oldcompcz/Mato-replica/KiCad/Mato/pcb-src/mato-back.png

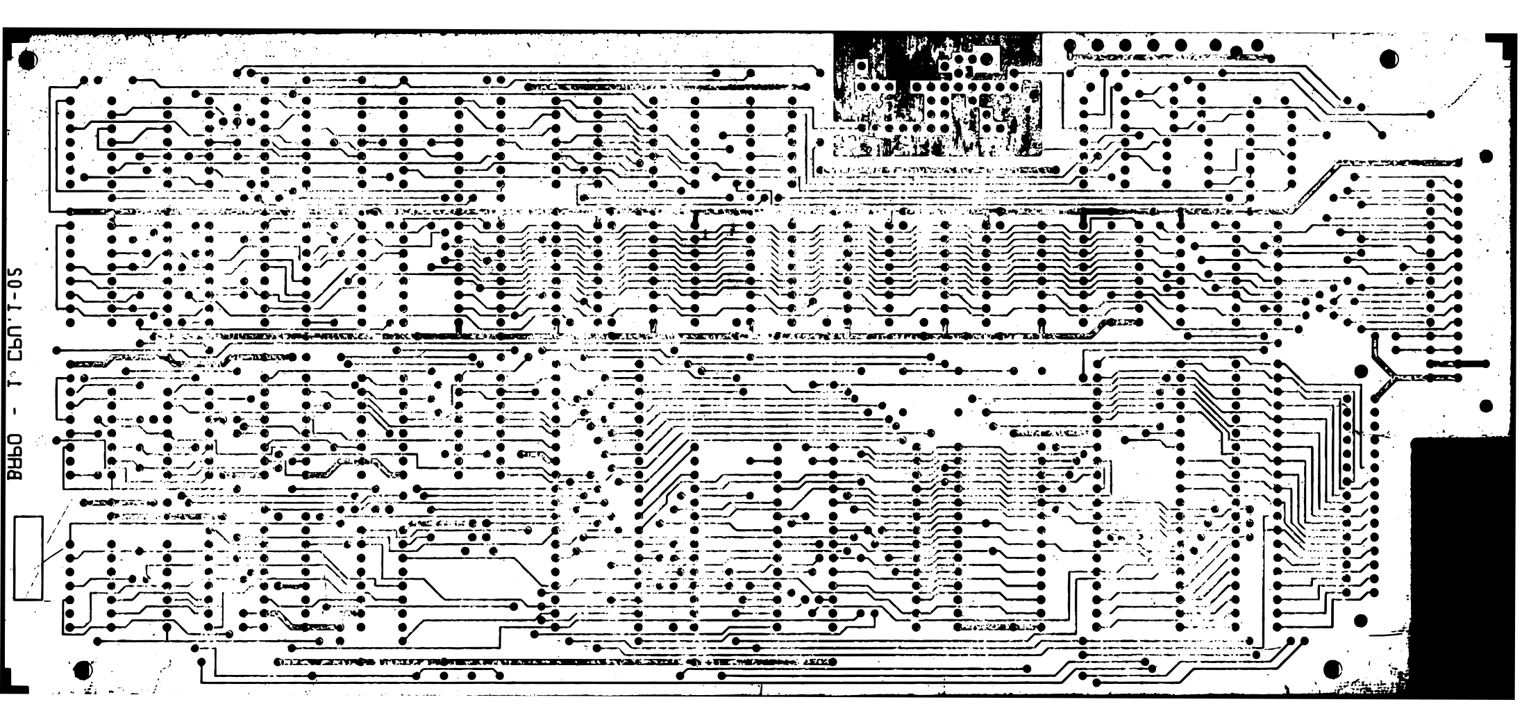
KiCad/Mato/pcb-src/mato-back.png
