oldcompcz/Mato-replica/KiCad/Mato/pcb-src/mato-front.png

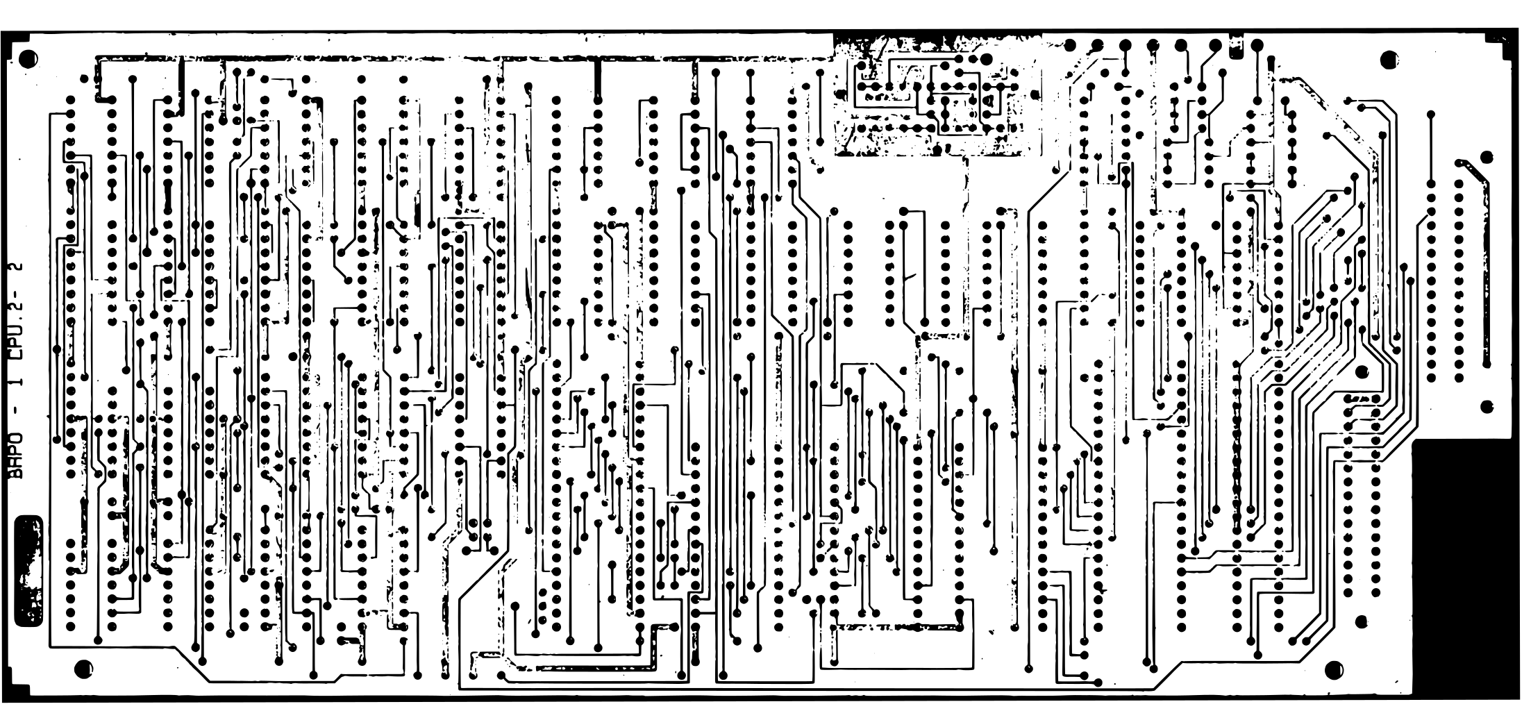
KiCad/Mato/pcb-src/mato-front.png
