oldcompcz/Mato-replica/Schemes/Stavebnica_mikropocitaca_MATO_scan_Zarucny_list_300.jpg

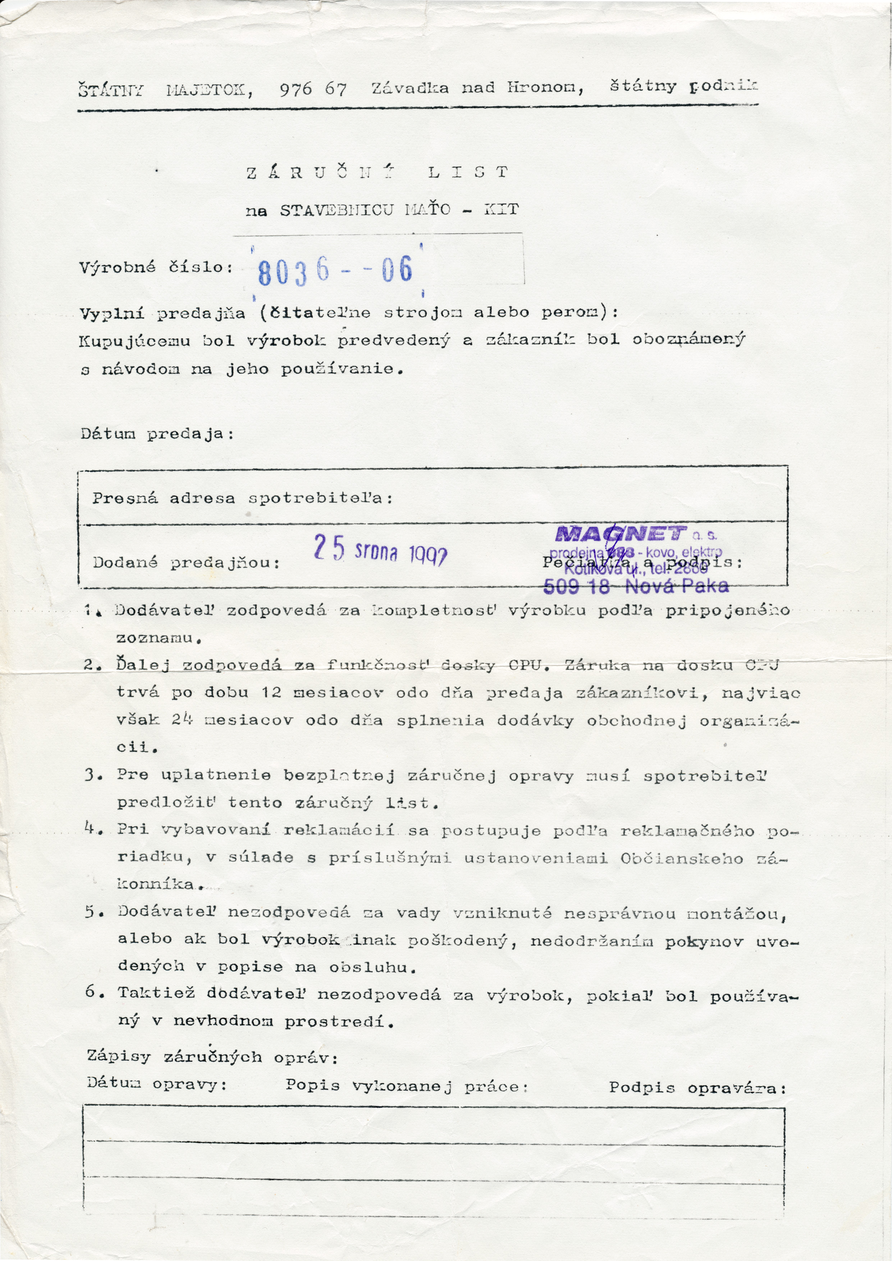
Schemes/Stavebnica_mikropocitaca_MATO_scan_Zarucny_list_300.jpg
