oldcompcz/Mato-replica/KiCad/Mato.kicad_pcb

## KiCad design KiCad/Mato.kicad_pcb (2021-07-30)

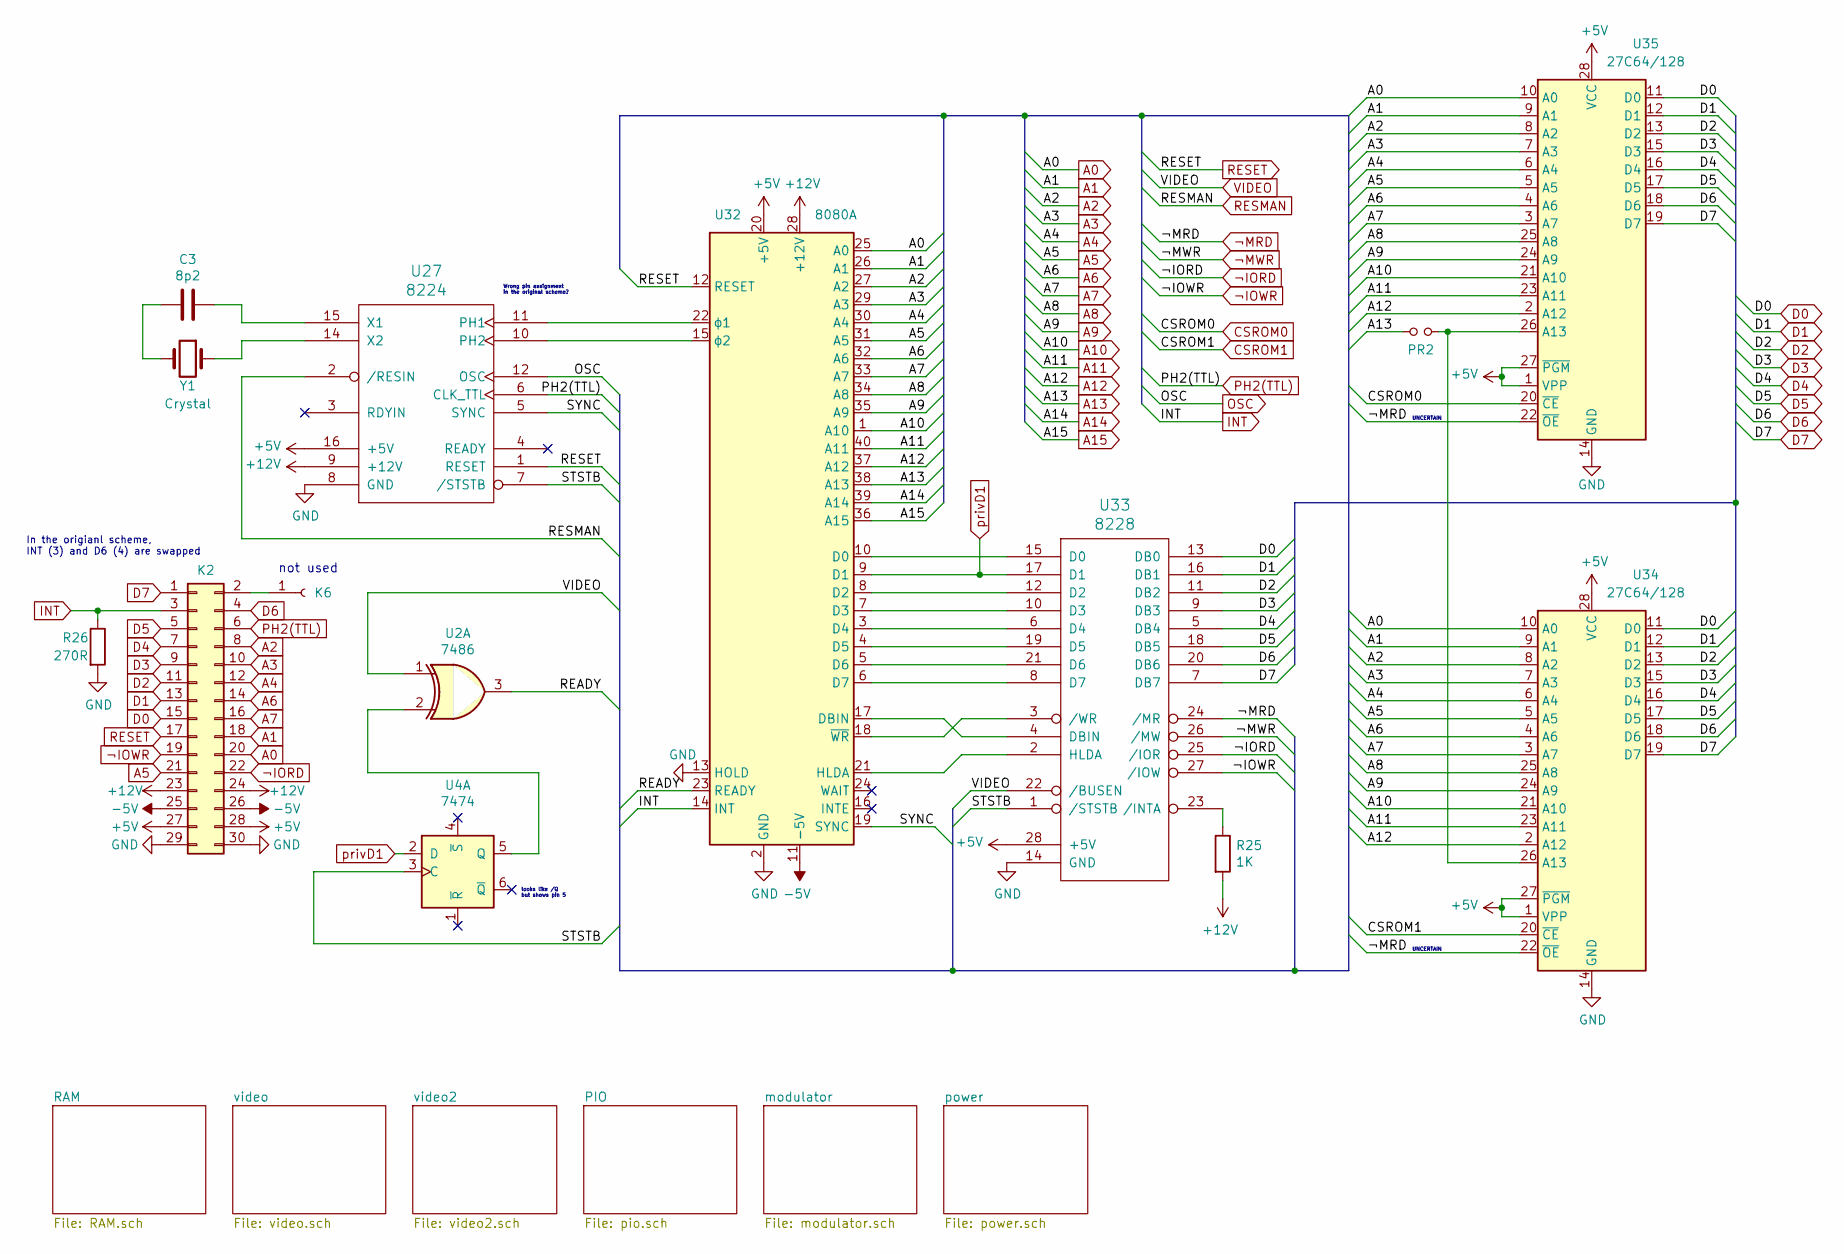
[picture p6: schematic Mato.sch]

Parts:
C3: 8p2; C_Disc_D3.4mm_W2.1mm_P2.50mm
K2: Conn_02x15_Odd_Even; TX5133011-mato
K6: K6; mato-K6
PR2: Jumper_NO_Small; PinHeader_1x02_P2.54mm_Vertical
R25: 1K; R_Axial_DIN0204_L3.6mm_D1.6mm_P7.62mm_Horizontal
R26: 270R; R_Axial_Bend
U2: 7486; DIP-14_W7.62mm
U4: 7474; DIP-14_W7.62mm
U27: 8224; DIP-16_W7.62mm
U32: 8080A; DIP-40_W15.24mm
U33: 8228; DIP-28_W15.24mm
U34, U35: 27C64/128; DIP-28_W15.24mm
Y1: Crystal; Crystal_HC18-U_Horizontal

Connections:
+5V: K2.27, K2.28, U27.16 (+5V), U32.20 (+5V), U33.28 (+5V), U34.1 (VPP), U34.27 (~PGM), U34.28 (VCC), U35.1 (VPP), U35.27 (~PGM), U35.28 (VCC); also elsewhere on the board
+12V: K2.23, K2.24, R25.2, U27.9 (+12V), U32.28 (+12V); also elsewhere on the board
-5V: K2.25, K2.26, U32.11 (-5V); also elsewhere on the board
/READY: U2.3, U32.23 (READY)
/STSTB: U4.3 (C), U27.7 (/STSTB), U33.1 (/STSTB)
/SYNC: U27.5 (SYNC), U32.19 (SYNC)
A0: K2.20, U32.25 (A0), U34.10 (A0), U35.10 (A0); also elsewhere on the board
A1: K2.18, U32.26 (A1), U34.9 (A1), U35.9 (A1); also elsewhere on the board
A2: K2.8, U32.27 (A2), U34.8 (A2), U35.8 (A2); also elsewhere on the board
A3: K2.10, U32.29 (A3), U34.7 (A3), U35.7 (A3); also elsewhere on the board
A4: K2.12, U32.30 (A4), U34.6 (A4), U35.6 (A4); also elsewhere on the board
A5: K2.21, U32.31 (A5), U34.5 (A5), U35.5 (A5); also elsewhere on the board
A6: K2.14, U32.32 (A6), U34.4 (A6), U35.4 (A6); also elsewhere on the board
A7: K2.16, U32.33 (A7), U34.3 (A7), U35.3 (A7); also elsewhere on the board
A8: U32.34 (A8), U34.25 (A8), U35.25 (A8); also elsewhere on the board
A9: U32.35 (A9), U34.24 (A9), U35.24 (A9); also elsewhere on the board
A10: U32.1 (A10), U34.21 (A10), U35.21 (A10); also elsewhere on the board
A11: U32.40 (A11), U34.23 (A11), U35.23 (A11); also elsewhere on the board
A12: U32.37 (A12), U34.2 (A12), U35.2 (A12); also elsewhere on the board
A13: PR2.1, U32.38 (A13); also elsewhere on the board
A14: U32.39 (A14); also elsewhere on the board
A15: U32.36 (A15); also elsewhere on the board
CSROM0: U35.20 (~CE); also elsewhere on the board
CSROM1: U34.20 (~CE); also elsewhere on the board
D0: K2.15, U33.13 (DB0), U34.11 (D0), U35.11 (D0); also elsewhere on the board
D1: K2.13, U33.16 (DB1), U34.12 (D1), U35.12 (D1); also elsewhere on the board
D2: K2.11, U33.11 (DB2), U34.13 (D2), U35.13 (D2); also elsewhere on the board
D3: K2.9, U33.9 (DB3), U34.15 (D3), U35.15 (D3); also elsewhere on the board
D4: K2.7, U33.5 (DB4), U34.16 (D4), U35.16 (D4); also elsewhere on the board
D5: K2.5, U33.18 (DB5), U34.17 (D5), U35.17 (D5); also elsewhere on the board
D6: K2.4, U33.20 (DB6), U34.18 (D6), U35.18 (D6); also elsewhere on the board
D7: K2.1, U33.7 (DB7), U34.19 (D7), U35.19 (D7); also elsewhere on the board
GND: K2.29, K2.30, R26.2, U27.8 (GND), U32.2 (GND), U32.13 (HOLD), U33.14 (GND), U34.14 (GND), U35.14 (GND); also elsewhere on the board
INT: K2.3, R26.1, U32.14 (INT)
unnamed: C3.1, Y1.2
unnamed: C3.2, U27.15 (X1)
unnamed: K2.2, K6.1
unnamed: PR2.2, U34.26 (A13), U35.26 (A13)
unnamed: R25.1, U33.23 (/INTA)
unnamed: U2.2, U4.5 (Q)
unnamed: U27.10 (PH2), U32.15 (ϕ2)
unnamed: U27.11 (PH1), U32.22 (ϕ1)
unnamed: U27.14 (X2), Y1.1
unnamed: U32.3 (D4), U33.6 (D4)
unnamed: U32.4 (D5), U33.19 (D5)
unnamed: U32.5 (D6), U33.21 (D6)
unnamed: U32.6 (D7), U33.8 (D7)
unnamed: U32.7 (D3), U33.10 (D3)
unnamed: U32.8 (D2), U33.12 (D2)
unnamed: U32.10 (D0), U33.15 (D0)
unnamed: U32.17 (DBIN), U33.4 (DBIN)
unnamed: U32.18 (~WR~), U33.3 (/WR)
unnamed: U32.21 (HLDA), U33.2 (HLDA)
OSC: U27.12 (OSC); also elsewhere on the board
PH2(TTL): K2.6, U27.6 (CLK_TTL); also elsewhere on the board
RESET: K2.17, U27.1 (RESET), U32.12 (RESET); also elsewhere on the board
RESMAN: U27.2 (/RESIN); also elsewhere on the board
VIDEO: U2.1, U33.22 (/BUSEN); also elsewhere on the board
privD1: U4.2 (D), U32.9 (D1), U33.17 (D1)
¬IORD: K2.22, U33.25 (/IOR); also elsewhere on the board
¬IOWR: K2.19, U33.27 (/IOW); also elsewhere on the board
¬MRD: U33.24 (/MR), U34.22 (~OE), U35.22 (~OE); also elsewhere on the board
¬MWR: U33.26 (/MW); also elsewhere on the board

Notes on the sheet:
looks like /Q but shows pin 5
Wrong pin assignment in the original scheme?
UNCERTAIN
In the origianl scheme, INT (3) and D6 (4) are swapped
not used

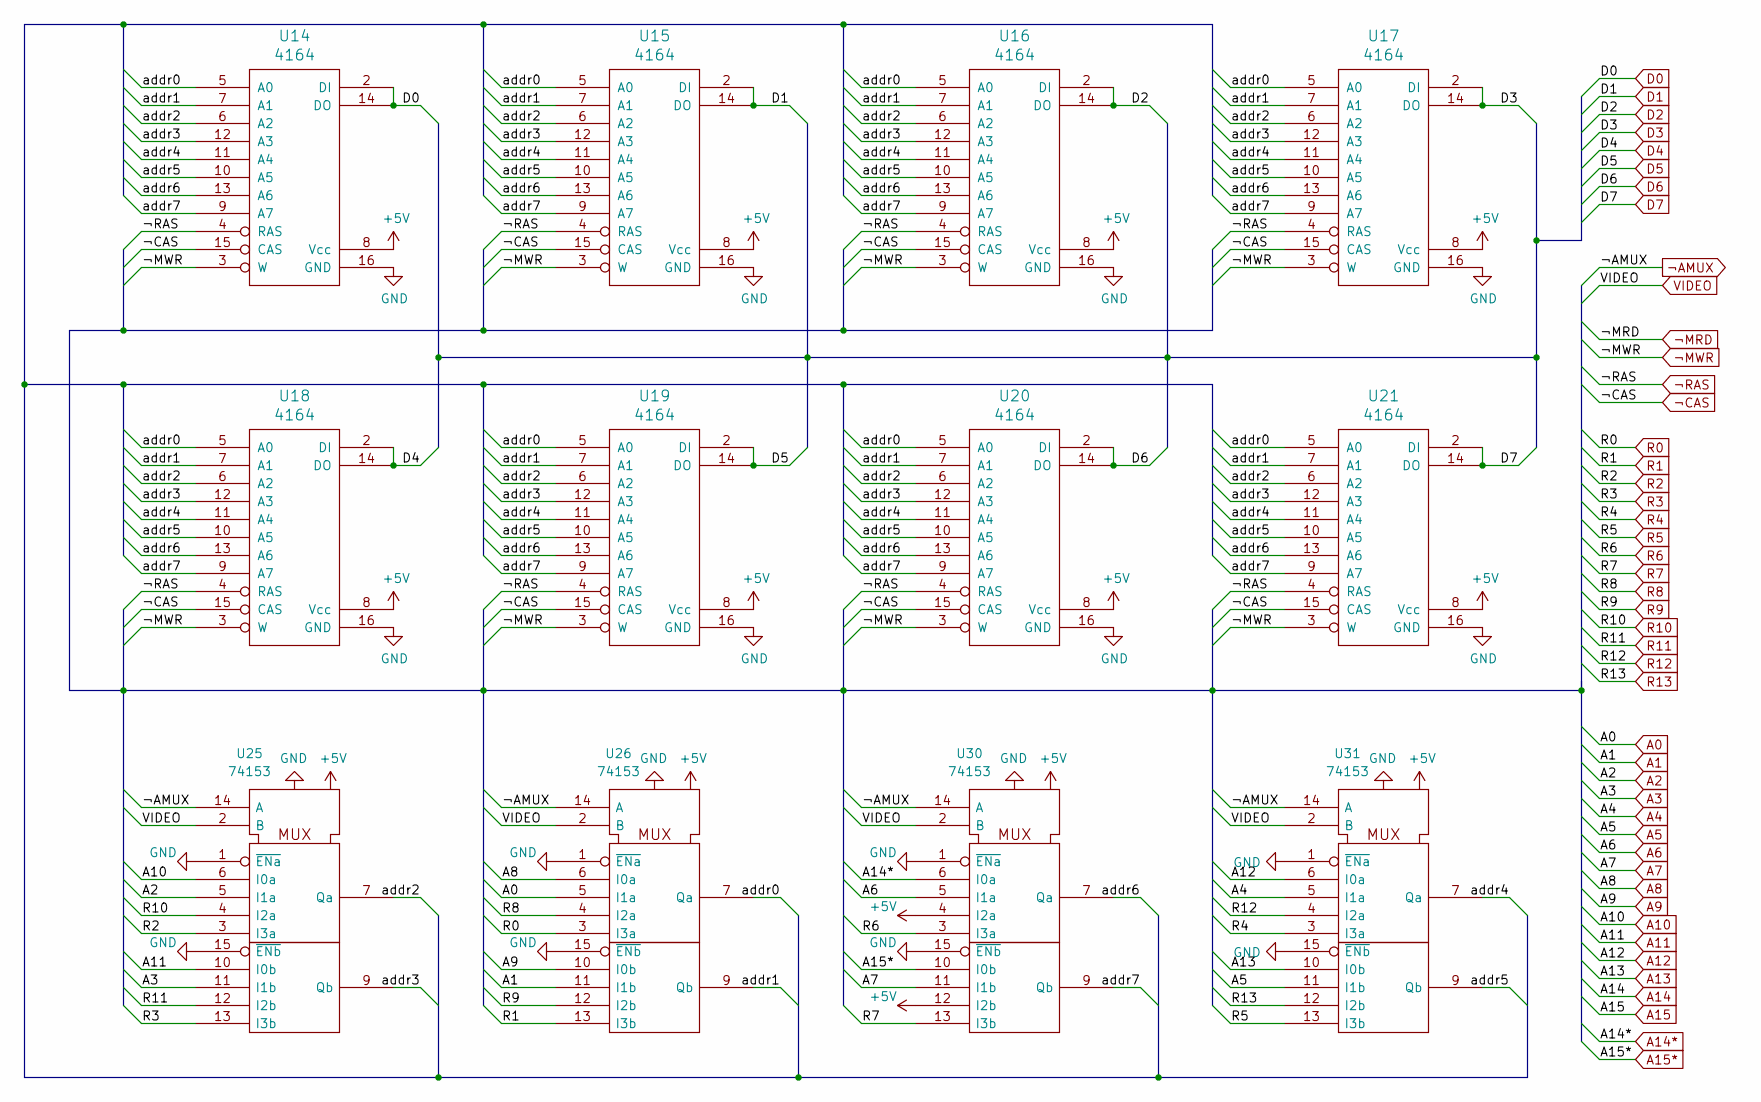
[picture p7: schematic RAM.sch]

Parts:
U14, U15, U16, U17, U18, U19, U20, U21: 4164; DIP-16_W7.62mm
U25, U26, U30, U31: 74153; DIP-16_W7.62mm

Connections:
+5V: U14.8 (Vcc), U15.8 (Vcc), U16.8 (Vcc), U17.8 (Vcc), U18.8 (Vcc), U19.8 (Vcc), U20.8 (Vcc), U21.8 (Vcc), U25.16 (VCC), U26.16 (VCC), U30.4 (I2a), U30.12 (I2b), U30.16 (VCC), U31.16 (VCC); also elsewhere on the board
/RAM/addr0: U14.5 (A0), U15.5 (A0), U16.5 (A0), U17.5 (A0), U18.5 (A0), U19.5 (A0), U20.5 (A0), U21.5 (A0), U26.7 (Qa)
/RAM/addr1: U14.7 (A1), U15.7 (A1), U16.7 (A1), U17.7 (A1), U18.7 (A1), U19.7 (A1), U20.7 (A1), U21.7 (A1), U26.9 (Qb)
/RAM/addr2: U14.6 (A2), U15.6 (A2), U16.6 (A2), U17.6 (A2), U18.6 (A2), U19.6 (A2), U20.6 (A2), U21.6 (A2), U25.7 (Qa)
/RAM/addr3: U14.12 (A3), U15.12 (A3), U16.12 (A3), U17.12 (A3), U18.12 (A3), U19.12 (A3), U20.12 (A3), U21.12 (A3), U25.9 (Qb)
/RAM/addr4: U14.11 (A4), U15.11 (A4), U16.11 (A4), U17.11 (A4), U18.11 (A4), U19.11 (A4), U20.11 (A4), U21.11 (A4), U31.7 (Qa)
/RAM/addr5: U14.10 (A5), U15.10 (A5), U16.10 (A5), U17.10 (A5), U18.10 (A5), U19.10 (A5), U20.10 (A5), U21.10 (A5), U31.9 (Qb)
/RAM/addr6: U14.13 (A6), U15.13 (A6), U16.13 (A6), U17.13 (A6), U18.13 (A6), U19.13 (A6), U20.13 (A6), U21.13 (A6), U30.7 (Qa)
/RAM/addr7: U14.9 (A7), U15.9 (A7), U16.9 (A7), U17.9 (A7), U18.9 (A7), U19.9 (A7), U20.9 (A7), U21.9 (A7), U30.9 (Qb)
A0: U26.5 (I1a); also elsewhere on the board
A1: U26.11 (I1b); also elsewhere on the board
A2: U25.5 (I1a); also elsewhere on the board
A3: U25.11 (I1b); also elsewhere on the board
A4: U31.5 (I1a); also elsewhere on the board
A5: U31.11 (I1b); also elsewhere on the board
A6: U30.5 (I1a); also elsewhere on the board
A7: U30.11 (I1b); also elsewhere on the board
A8: U26.6 (I0a); also elsewhere on the board
A9: U26.10 (I0b); also elsewhere on the board
A10: U25.6 (I0a); also elsewhere on the board
A11: U25.10 (I0b); also elsewhere on the board
A12: U31.6 (I0a); also elsewhere on the board
A13: U31.10 (I0b); also elsewhere on the board
A14*: U30.6 (I0a); also elsewhere on the board
A15*: U30.10 (I0b); also elsewhere on the board
D0: U14.2 (DI), U14.14 (DO); also elsewhere on the board
D1: U15.2 (DI), U15.14 (DO); also elsewhere on the board
D2: U16.2 (DI), U16.14 (DO); also elsewhere on the board
D3: U17.2 (DI), U17.14 (DO); also elsewhere on the board
D4: U18.2 (DI), U18.14 (DO); also elsewhere on the board
D5: U19.2 (DI), U19.14 (DO); also elsewhere on the board
D6: U20.2 (DI), U20.14 (DO); also elsewhere on the board
D7: U21.2 (DI), U21.14 (DO); also elsewhere on the board
GND: U14.16 (GND), U15.16 (GND), U16.16 (GND), U17.16 (GND), U18.16 (GND), U19.16 (GND), U20.16 (GND), U21.16 (GND), U25.1 (~ENa), U25.8 (GND), U25.15 (~ENb), U26.1 (~ENa), U26.8 (GND), U26.15 (~ENb), U30.1 (~ENa), U30.8 (GND), U30.15 (~ENb), U31.1 (~ENa), U31.8 (GND), U31.15 (~ENb); also elsewhere on the board
R0: U26.3 (I3a); also elsewhere on the board
R1: U26.13 (I3b); also elsewhere on the board
R2: U25.3 (I3a); also elsewhere on the board
R3: U25.13 (I3b); also elsewhere on the board
R4: U31.3 (I3a); also elsewhere on the board
R5: U31.13 (I3b); also elsewhere on the board
R6: U30.3 (I3a); also elsewhere on the board
R7: U30.13 (I3b); also elsewhere on the board
R8: U26.4 (I2a); also elsewhere on the board
R9: U26.12 (I2b); also elsewhere on the board
R10: U25.4 (I2a); also elsewhere on the board
R11: U25.12 (I2b); also elsewhere on the board
R12: U31.4 (I2a); also elsewhere on the board
R13: U31.12 (I2b); also elsewhere on the board
VIDEO: U25.2 (B), U26.2 (B), U30.2 (B), U31.2 (B); also elsewhere on the board
¬AMUX: U25.14 (A), U26.14 (A), U30.14 (A), U31.14 (A); also elsewhere on the board
¬CAS: U14.15 (CAS), U15.15 (CAS), U16.15 (CAS), U17.15 (CAS), U18.15 (CAS), U19.15 (CAS), U20.15 (CAS), U21.15 (CAS); also elsewhere on the board
¬MWR: U14.3 (W), U15.3 (W), U16.3 (W), U17.3 (W), U18.3 (W), U19.3 (W), U20.3 (W), U21.3 (W); also elsewhere on the board
¬RAS: U14.4 (RAS), U15.4 (RAS), U16.4 (RAS), U17.4 (RAS), U18.4 (RAS), U19.4 (RAS), U20.4 (RAS), U21.4 (RAS); also elsewhere on the board

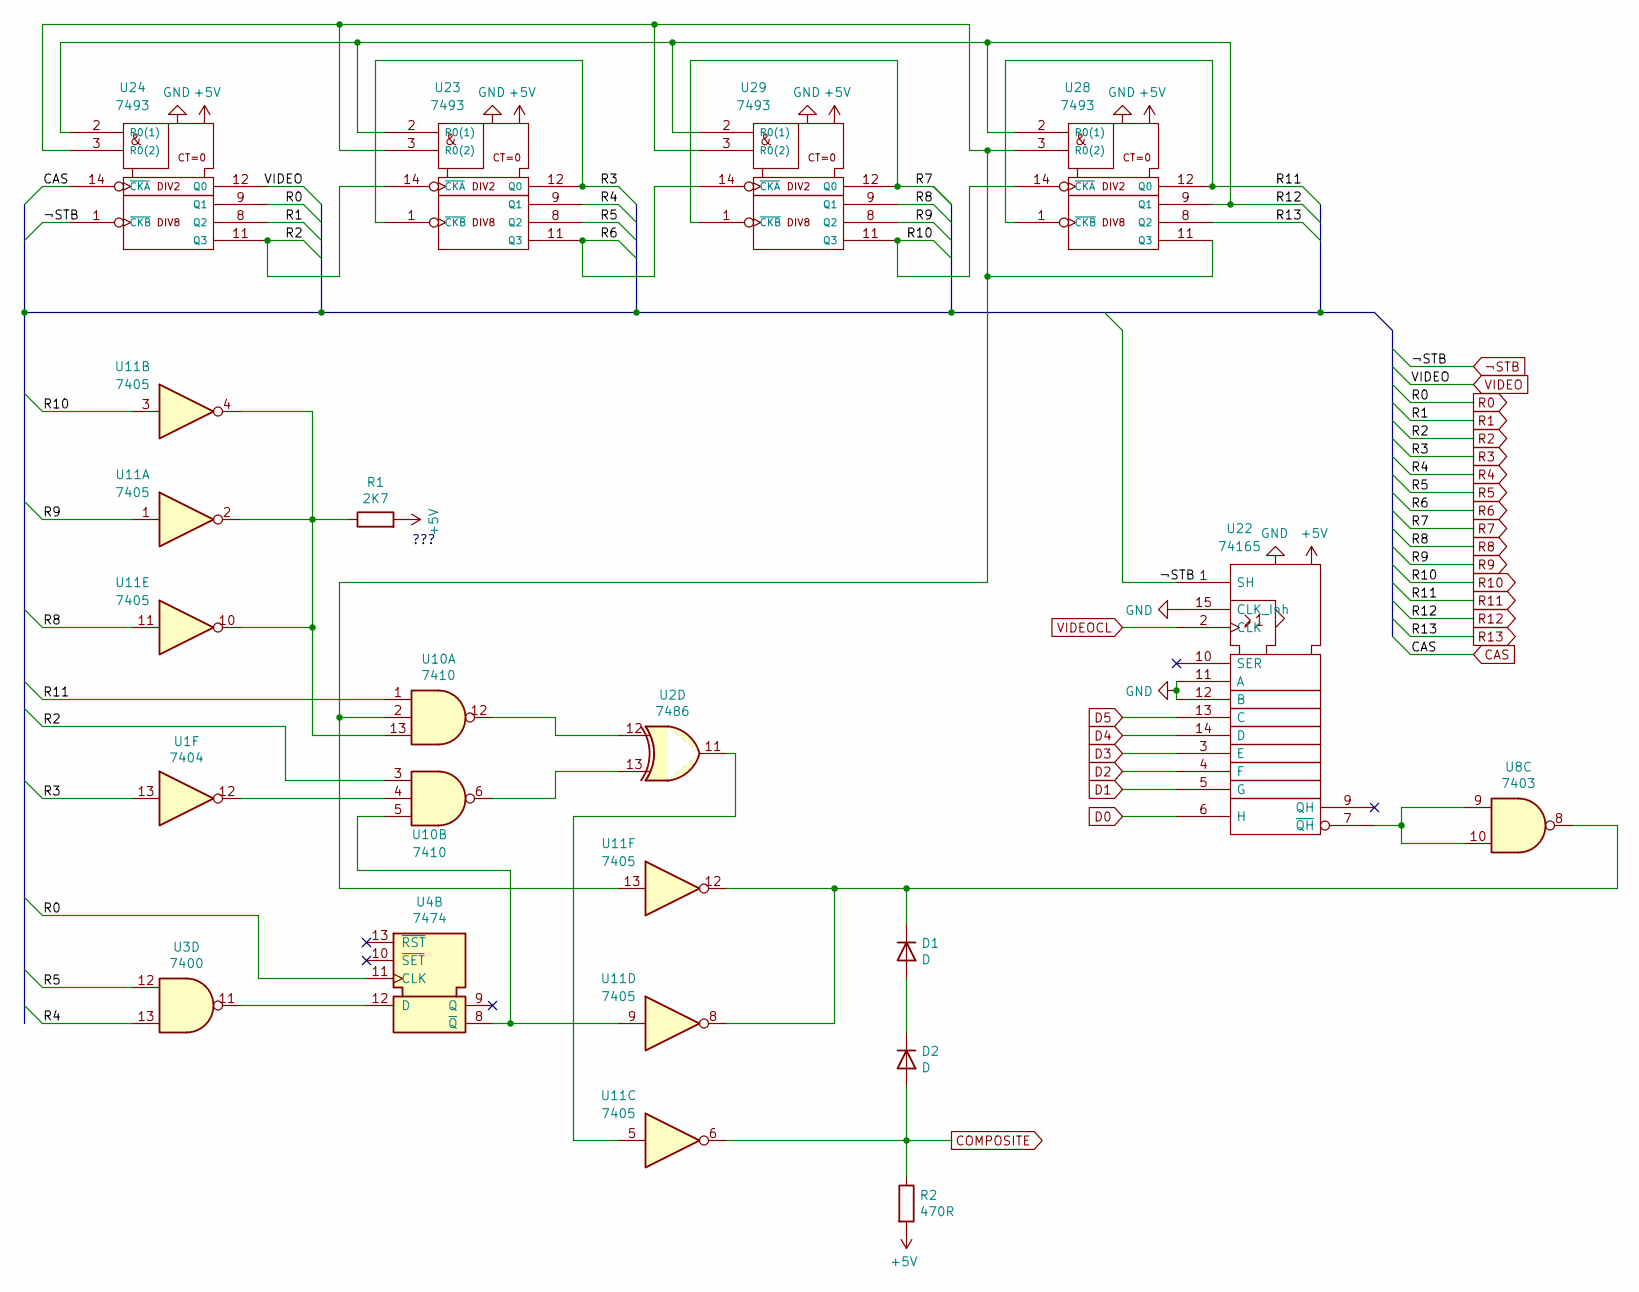
[picture p8: schematic video.sch]

Parts:
D1, D2: D; D_DO-34_SOD68_P7.62mm_Horizontal
R1: 2K7; R_Axial_DIN0204_L3.6mm_D1.6mm_P7.62mm_Horizontal
R2: 470R; R_Axial_DIN0204_L3.6mm_D1.6mm_P7.62mm_Horizontal
U1: 7404; DIP-14_W7.62mm
U2: 7486; DIP-14_W7.62mm
U3: 7400; DIP-14_W7.62mm
U4: 7474; DIP-14_W7.62mm
U8: 7403; DIP-14_W7.62mm
U10: 7410; DIP-14_W7.62mm
U11: 7405; DIP-14_W7.62mm
U22: 74165; DIP-16_W7.62mm
U23, U24, U28, U29: 7493; DIP-14_W7.62mm

Connections:
+5V: R1.2, R2.2, U22.16 (VCC), U23.5 (VCC), U24.5 (VCC), U28.5 (VCC), U29.5 (VCC); also elsewhere on the board
CAS: U24.14 (~CKA); also elsewhere on the board
COMPOSITE: D2.2 (A), R2.1, U11.6; also elsewhere on the board
D0: U22.6 (H); also elsewhere on the board
D1: U22.5 (G); also elsewhere on the board
D2: U22.4 (F); also elsewhere on the board
D3: U22.3 (E); also elsewhere on the board
D4: U22.14 (D); also elsewhere on the board
D5: U22.13 (C); also elsewhere on the board
GND: U22.8 (GND), U22.11 (A), U22.12 (B), U22.15 (CLK_Inh), U23.10 (GND), U24.10 (GND), U28.10 (GND), U29.10 (GND); also elsewhere on the board
unnamed: D1.1 (K), U8.8, U11.8, U11.12
unnamed: D1.2 (A), D2.1 (K)
unnamed: R1.1, U10.13, U11.2, U11.4, U11.10
unnamed: U1.12, U10.4
unnamed: U3.11, U4.12 (D)
unnamed: U10.2, U11.13, U23.3 (R0(2)), U24.3 (R0(2)), U28.3 (R0(2)), U28.11 (Q3), U29.3 (R0(2))
unnamed: U4.8 (~Q), U10.5, U11.9
unnamed: U2.13, U10.6
unnamed: U2.12, U10.12
unnamed: U2.11, U11.5
unnamed: U8.9, U8.10, U22.7 (~QH)
R0: U4.11 (C), U24.9 (Q1); also elsewhere on the board
R1: U24.8 (Q2); also elsewhere on the board
R2: U10.3, U23.14 (~CKA), U24.11 (Q3); also elsewhere on the board
R3: U1.13, U23.1 (~CKB), U23.12 (Q0); also elsewhere on the board
R4: U3.13, U23.9 (Q1); also elsewhere on the board
R5: U3.12, U23.8 (Q2); also elsewhere on the board
R6: U23.11 (Q3), U29.14 (~CKA); also elsewhere on the board
R7: U29.1 (~CKB), U29.12 (Q0); also elsewhere on the board
R8: U11.11, U29.9 (Q1); also elsewhere on the board
R9: U11.1, U29.8 (Q2); also elsewhere on the board
R10: U11.3, U28.14 (~CKA), U29.11 (Q3); also elsewhere on the board
R11: U10.1, U28.1 (~CKB), U28.12 (Q0); also elsewhere on the board
R12: U23.2 (R0(1)), U24.2 (R0(1)), U28.2 (R0(1)), U28.9 (Q1), U29.2 (R0(1)); also elsewhere on the board
R13: U28.8 (Q2); also elsewhere on the board
VIDEO: U24.12 (Q0); also elsewhere on the board
VIDEOCL: U22.2 (CLK); also elsewhere on the board
¬STB: U22.1 (SH), U24.1 (~CKB); also elsewhere on the board

Notes on the sheet:
???

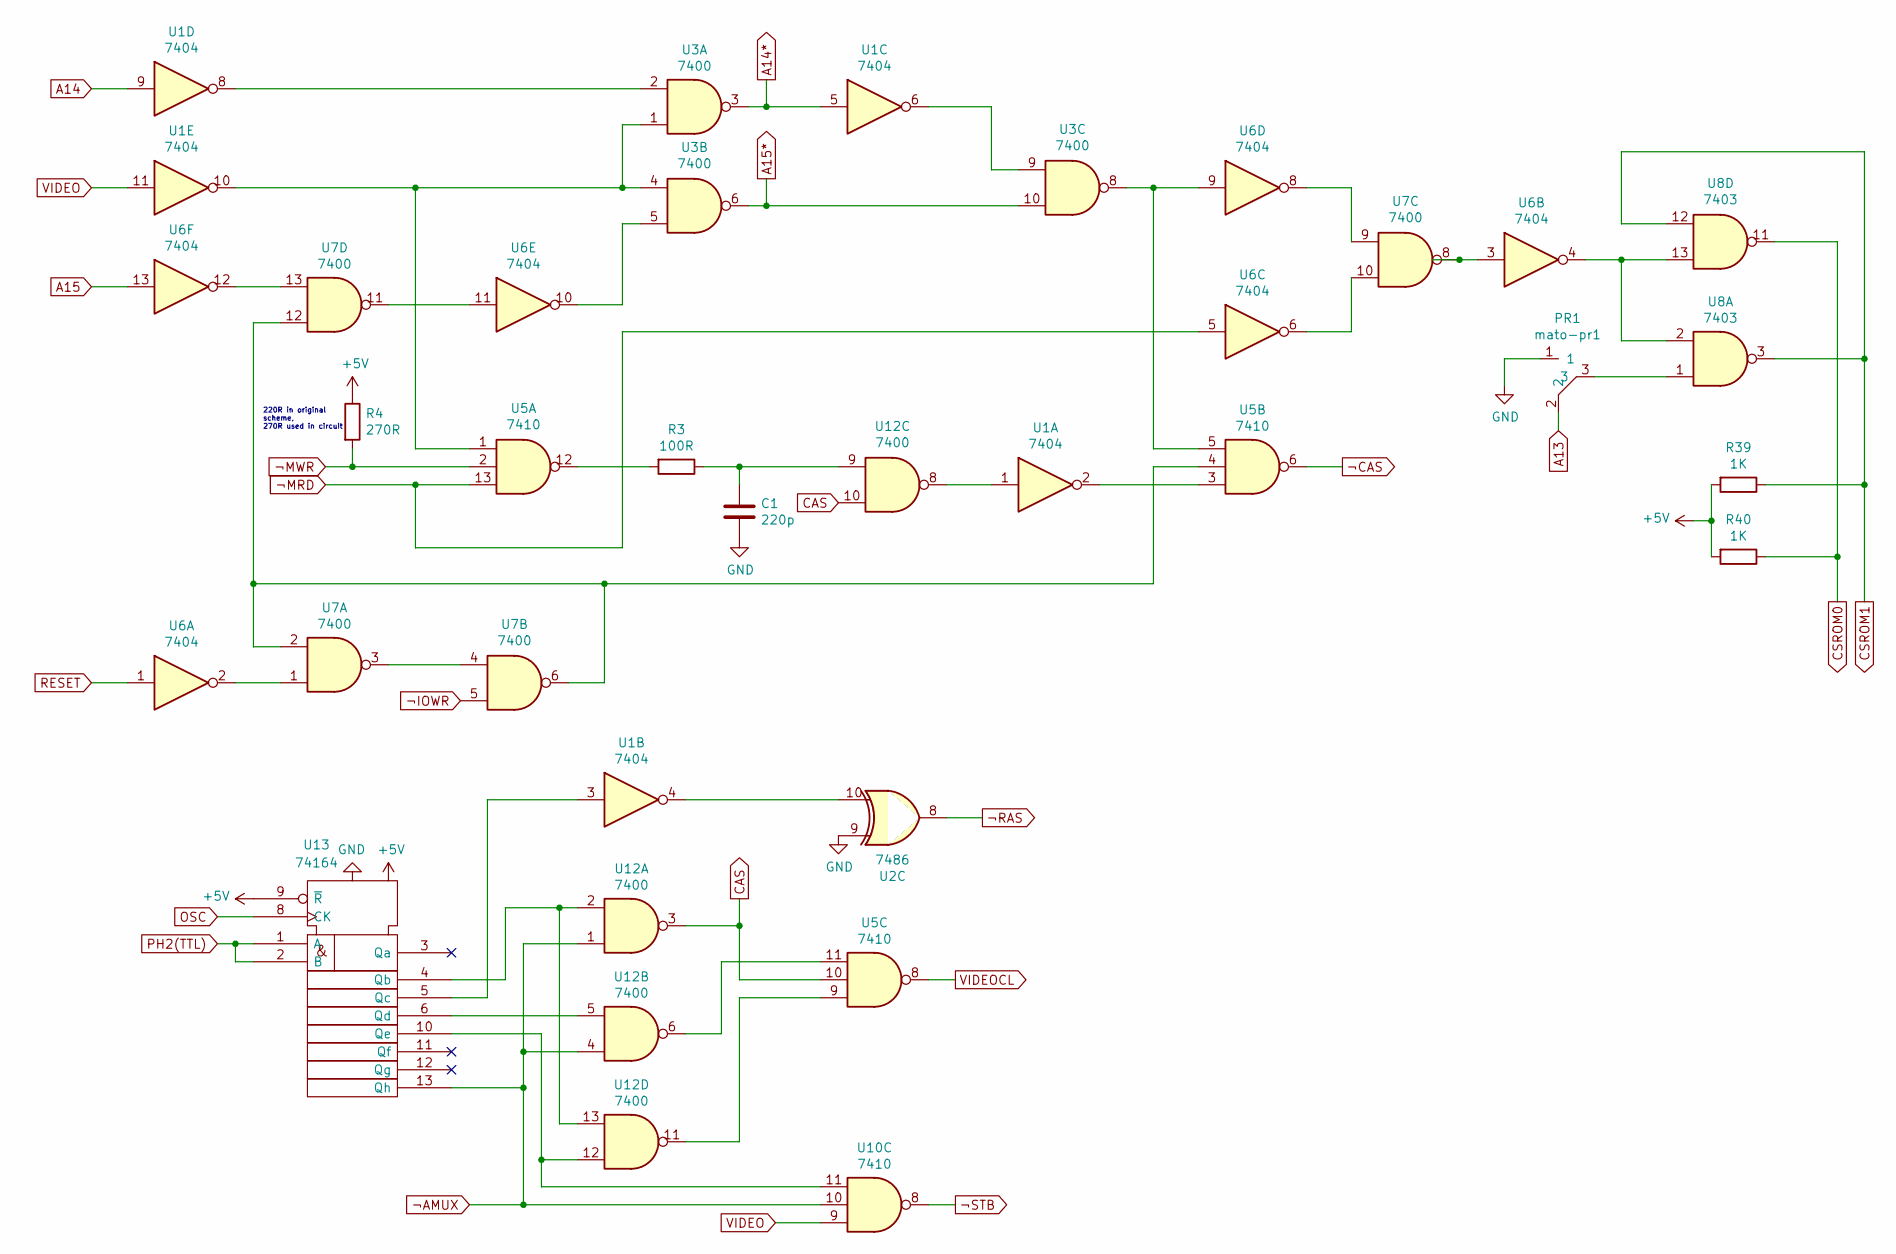
[picture p9: schematic video2.sch]

Parts:
C1: 220p; C_Disc_D4.3mm_W1.9mm_P5.00mm
PR1: mato-pr1; PinHeader_1x03_P2.54mm_Vertical
R3: 100R; R_Axial_DIN0204_L3.6mm_D1.6mm_P7.62mm_Horizontal
R4: 270R; R_Axial_DIN0204_L3.6mm_D1.6mm_P7.62mm_Horizontal
R39, R40: 1K; R_Axial_DIN0204_L3.6mm_D1.6mm_P7.62mm_Horizontal
U1, U6: 7404; DIP-14_W7.62mm
U2: 7486; DIP-14_W7.62mm
U3, U7, U12: 7400; DIP-14_W7.62mm
U5, U10: 7410; DIP-14_W7.62mm
U8: 7403; DIP-14_W7.62mm
U13: 74164; DIP-14_W7.62mm

Connections:
+5V: R4.1, R39.2, R40.2, U13.9 (~R), U13.14 (Vdd); also elsewhere on the board
A13: PR1.2; also elsewhere on the board
A14: U1.9; also elsewhere on the board
A14*: U1.5, U3.3; also elsewhere on the board
A15: U6.13; also elsewhere on the board
A15*: U3.6, U3.10; also elsewhere on the board
CAS: U5.10, U12.3, U12.10; also elsewhere on the board
CSROM0: R40.1, U8.11; also elsewhere on the board
CSROM1: R39.1, U8.3, U8.12; also elsewhere on the board
GND: C1.2, PR1.1, U2.9, U13.7 (Vss); also elsewhere on the board
unnamed: C1.1, R3.1, U12.9
unnamed: PR1.3, U8.1
unnamed: R3.2, U5.12
unnamed: U1.1, U12.8
unnamed: U1.2, U5.3
unnamed: U1.3, U13.5 (Qc)
unnamed: U1.4, U2.10
unnamed: U1.6, U3.9
unnamed: U1.8, U3.2
unnamed: U1.10, U3.1, U3.4, U5.1
unnamed: U3.5, U6.10
unnamed: U3.8, U5.5, U6.9
unnamed: U5.4, U7.2, U7.6, U7.12
unnamed: U6.2, U7.1
unnamed: U6.3, U7.8
unnamed: U6.4, U8.2, U8.13
unnamed: U6.6, U7.10
unnamed: U6.8, U7.9
unnamed: U6.11, U7.11
unnamed: U6.12, U7.13
unnamed: U7.3, U7.4
unnamed: U10.11, U12.12, U13.10 (Qe)
unnamed: U12.5, U13.6 (Qd)
unnamed: U5.11, U12.6
unnamed: U5.9, U12.11
unnamed: U12.2, U12.13, U13.4 (Qb)
OSC: U13.8 (CK); also elsewhere on the board
PH2(TTL): U13.1 (A), U13.2 (B); also elsewhere on the board
RESET: U6.1; also elsewhere on the board
VIDEO: U1.11, U10.9; also elsewhere on the board
VIDEOCL: U5.8; also elsewhere on the board
¬AMUX: U10.10, U12.1, U12.4, U13.13 (Qh); also elsewhere on the board
¬CAS: U5.6; also elsewhere on the board
¬IOWR: U7.5; also elsewhere on the board
¬MRD: U5.13, U6.5; also elsewhere on the board
¬MWR: R4.2, U5.2; also elsewhere on the board
¬RAS: U2.8; also elsewhere on the board
¬STB: U10.8; also elsewhere on the board

Notes on the sheet:
220R in original scheme, 270R used in circuit

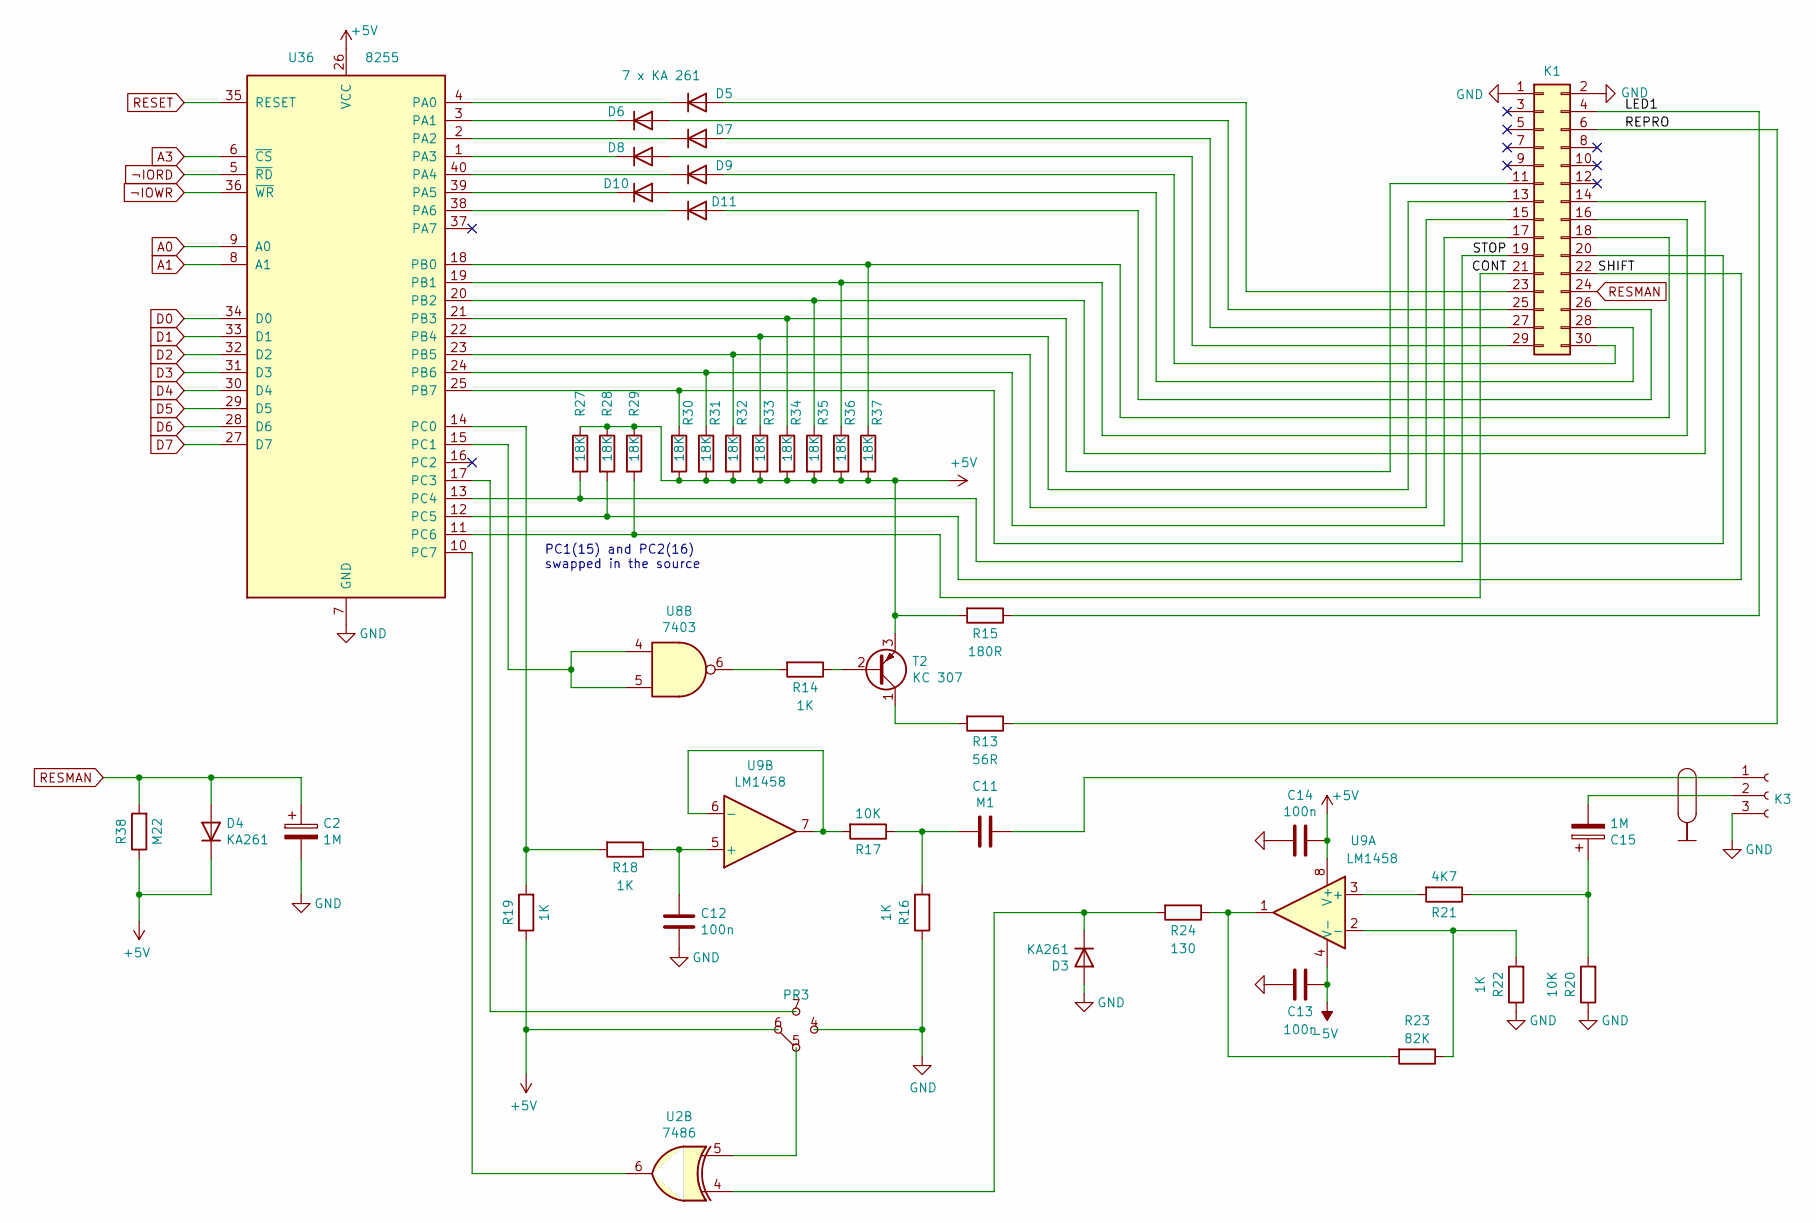
[picture p10: schematic pio.sch]

Parts:
C2: 1M; C_Disc_D3.4mm_W2.1mm_P2.50mm
C11: M1; C_Disc_D4.3mm_W1.9mm_P5.00mm
C12, C13, C14: 100n; C_Disc_D4.3mm_W1.9mm_P5.00mm
C15: 1M; C_Disc_D4.3mm_W1.9mm_P5.00mm
D3, D4: KA261; D_DO-34_SOD68_P7.62mm_Horizontal
D5: 7 x KA 261; D_DO-34_SOD68_P7.62mm_Horizontal
D6, D7, D8, D9, D10, D11: D; D_DO-34_SOD68_P7.62mm_Horizontal
K1: Conn_02x15_Odd_Even; TX5133012-mato
K3: K3; mato-K3
PR3: 4-point-link; mato-pr3
R13: 56R; R_Axial_DIN0204_L3.6mm_D1.6mm_P7.62mm_Horizontal
R14, R16, R18, R19, R22: 1K; R_Axial_DIN0204_L3.6mm_D1.6mm_P7.62mm_Horizontal
R15: 180R; R_Axial_DIN0204_L3.6mm_D1.6mm_P7.62mm_Horizontal
R17, R20: 10K; R_Axial_DIN0204_L3.6mm_D1.6mm_P7.62mm_Horizontal
R21: 4K7; R_Axial_DIN0204_L3.6mm_D1.6mm_P7.62mm_Horizontal
R23: 82K; R_Axial_DIN0204_L3.6mm_D1.6mm_P7.62mm_Horizontal
R24: 130; R_Axial_DIN0204_L3.6mm_D1.6mm_P7.62mm_Horizontal
R27, R28, R29, R30, R31, R32, R33, R34, R35, R36, R37: 18K; R_Axial_DIN0204_L3.6mm_D1.6mm_P7.62mm_Horizontal
R38: M22; R_Axial_DIN0204_L3.6mm_D1.6mm_P7.62mm_Horizontal
Sh1: Shield
T2: KC 307; mato-kc307
U2: 7486; DIP-14_W7.62mm
U8: 7403; DIP-14_W7.62mm
U9: LM1458; DIP-8_W7.62mm
U36: 8255; DIP-40_W15.24mm

Connections:
+5V: C14.2, D4.1 (K), PR3.6, R15.2, R19.1, R27.1, R28.1, R29.1, R30.2, R31.2, R32.2, R33.2, R34.2, R35.2, R36.2, R37.2, R38.1, T2.3 (E), U9.8 (V+), U36.26 (VCC); also elsewhere on the board
-5V: C13.2, U9.4 (V-); also elsewhere on the board
/PIO/CONT: K1.21, R29.2, U36.11 (PC6)
/PIO/LED1: K1.4, R15.1
/PIO/REPRO: K1.6, R13.1
/PIO/SHIFT: K1.22, R28.2, U36.12 (PC5)
/PIO/STOP: K1.19, R27.2, U36.13 (PC4)
A0: U36.9 (A0); also elsewhere on the board
A1: U36.8 (A1); also elsewhere on the board
A3: U36.6 (~CS~); also elsewhere on the board
D0: U36.34 (D0); also elsewhere on the board
D1: U36.33 (D1); also elsewhere on the board
D2: U36.32 (D2); also elsewhere on the board
D3: U36.31 (D3); also elsewhere on the board
D4: U36.30 (D4); also elsewhere on the board
D5: U36.29 (D5); also elsewhere on the board
D6: U36.28 (D6); also elsewhere on the board
D7: U36.27 (D7); also elsewhere on the board
GND: C2.2, C12.2, C13.1, C14.1, D3.2 (A), K1.1, K1.2, K3.3, PR3.4, R16.1, R20.1, R22.1, U36.7 (GND); also elsewhere on the board
unnamed: C11.1, R16.2, R17.1
unnamed: C11.2, K3.1
unnamed: C12.1, R18.1, U9.5 (+)
unnamed: C15.1, R20.2, R21.1
unnamed: C15.2, K3.2
unnamed: D3.1 (K), R24.2, U2.4
unnamed: D5.1 (K), U36.4 (PA0)
unnamed: D5.2 (A), K1.23
unnamed: D6.1 (K), U36.3 (PA1)
unnamed: D6.2 (A), K1.25
unnamed: D7.1 (K), U36.2 (PA2)
unnamed: D7.2 (A), K1.27
unnamed: D8.1 (K), U36.1 (PA3)
unnamed: D8.2 (A), K1.29
unnamed: D9.1 (K), U36.40 (PA4)
unnamed: D9.2 (A), K1.30
unnamed: D10.1 (K), U36.39 (PA5)
unnamed: D10.2 (A), K1.28
unnamed: D11.1 (K), U36.38 (PA6)
unnamed: D11.2 (A), K1.26
unnamed: K1.11, R34.1, U36.21 (PB3)
unnamed: K1.13, R33.1, U36.22 (PB4)
unnamed: K1.14, R35.1, U36.20 (PB2)
unnamed: K1.15, R32.1, U36.23 (PB5)
unnamed: K1.16, R36.1, U36.19 (PB1)
unnamed: K1.17, R31.1, U36.24 (PB6)
unnamed: K1.18, R37.1, U36.18 (PB0)
unnamed: K1.20, R30.1, U36.25 (PB7)
unnamed: PR3.5, U2.5
unnamed: PR3.7, U36.17 (PC3)
unnamed: R13.2, T2.1 (C)
unnamed: R14.1, T2.2 (B)
unnamed: R14.2, U8.6
unnamed: R17.2, U9.6 (-), U9.7
unnamed: R18.2, R19.2, U36.14 (PC0)
unnamed: R21.2, U9.3 (+)
unnamed: R22.2, R23.1, U9.2 (-)
unnamed: R23.2, R24.1, U9.1
unnamed: U2.6, U36.10 (PC7)
unnamed: U8.4, U8.5, U36.15 (PC1)
RESET: U36.35 (RESET); also elsewhere on the board
RESMAN: C2.1, D4.2 (A), K1.24, R38.2; also elsewhere on the board
¬IORD: U36.5 (~RD~); also elsewhere on the board
¬IOWR: U36.36 (~WR~); also elsewhere on the board

Notes on the sheet:
PC1(15) and PC2(16) swapped in the source
