oldcompcz/Mato-replica/KiCad/Mato.kicad_pcb

## KiCad design KiCad/Mato.kicad_pcb (continued)

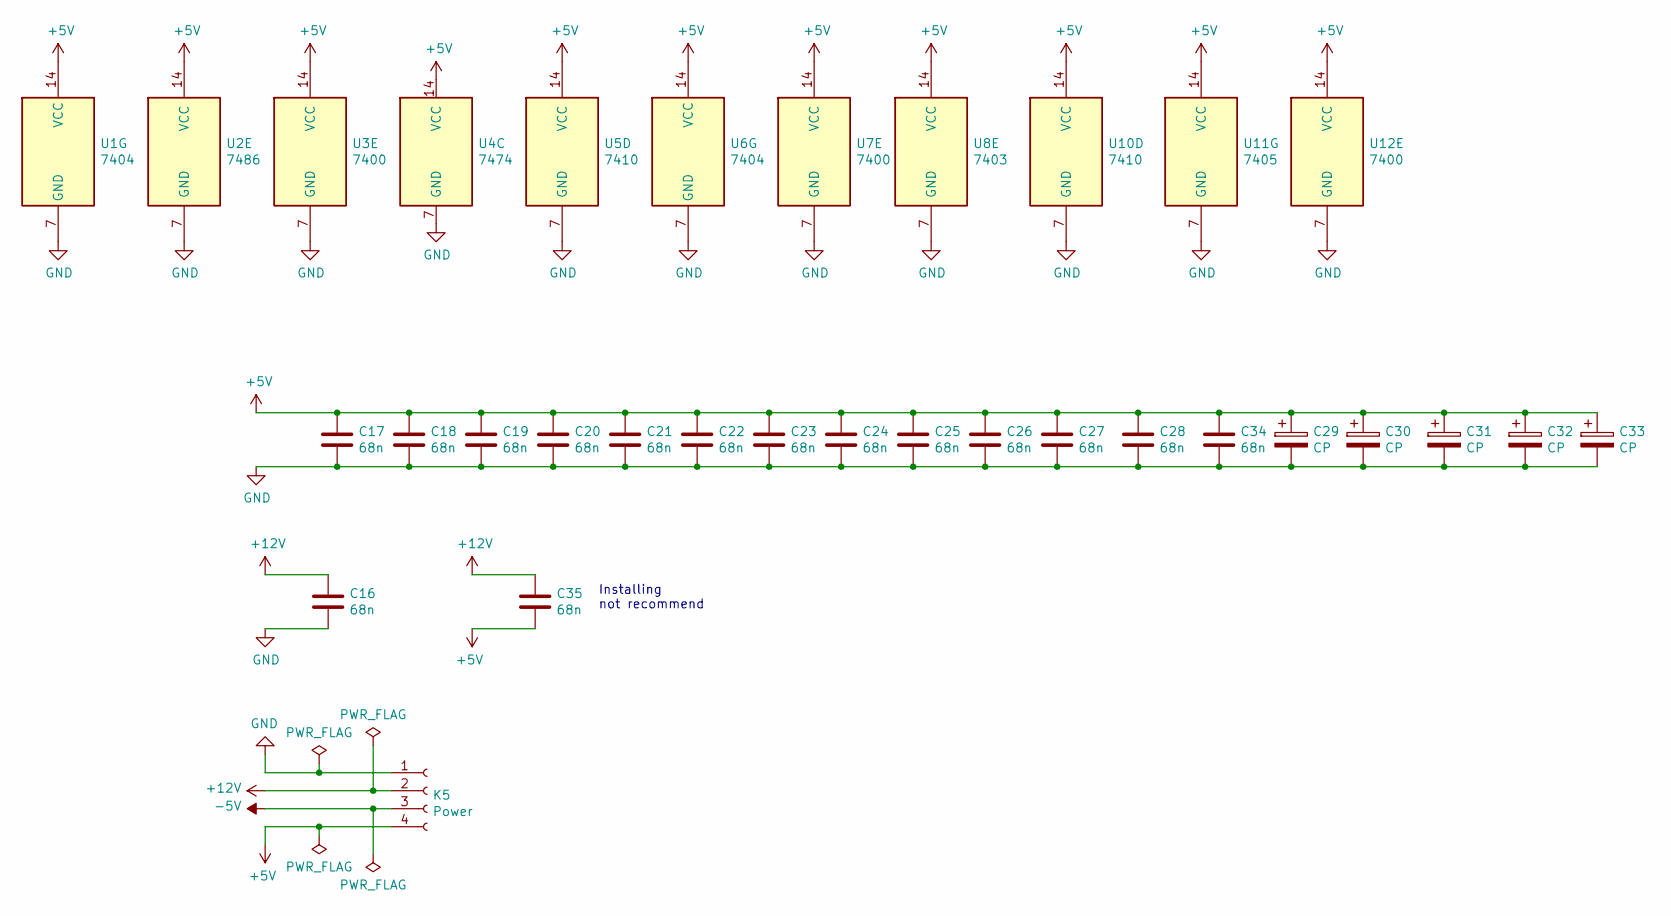
[picture p11: schematic power.sch]

Parts:
C16, C35: 68n; C_Disc_D6.0mm_W2.5mm_P5.00mm
C17, C18, C19, C20, C21, C22, C23, C24, C27, C28, C34: 68n; C_Disc_D3.0mm_W2.0mm_P2.50mm
C25, C26: 68n; C_Disc_D4.7mm_W2.5mm_P5.00mm
C29, C30, C31, C32, C33: CP; C_Disc_D3.0mm_W2.0mm_P2.50mm
K5: Power; mato-power
U1, U6: 7404; DIP-14_W7.62mm
U2: 7486; DIP-14_W7.62mm
U3, U7, U12: 7400; DIP-14_W7.62mm
U4: 7474; DIP-14_W7.62mm
U5, U10: 7410; DIP-14_W7.62mm
U8: 7403; DIP-14_W7.62mm
U11: 7405; DIP-14_W7.62mm

Connections:
+5V: C17.1, C18.1, C19.1, C20.1, C21.1, C22.1, C23.1, C24.1, C25.1, C26.1, C27.1, C28.1, C29.1, C30.1, C31.1, C32.1, C33.1, C34.1, C35.2, K5.4, U1.14 (VCC), U2.14 (VCC), U3.14 (VCC), U4.14 (VCC), U5.14 (VCC), U6.14 (VCC), U7.14 (VCC), U8.14 (VCC), U10.14 (VCC), U11.14 (VCC), U12.14 (VCC); also elsewhere on the board
+12V: C16.1, C35.1, K5.2; also elsewhere on the board
-5V: K5.3; also elsewhere on the board
GND: C16.2, C17.2, C18.2, C19.2, C20.2, C21.2, C22.2, C23.2, C24.2, C25.2, C26.2, C27.2, C28.2, C29.2, C30.2, C31.2, C32.2, C33.2, C34.2, K5.1, U1.7 (GND), U2.7 (GND), U3.7 (GND), U4.7 (GND), U5.7 (GND), U6.7 (GND), U7.7 (GND), U8.7 (GND), U10.7 (GND), U11.7 (GND), U12.7 (GND); also elsewhere on the board

Notes on the sheet:
Installing not recommend

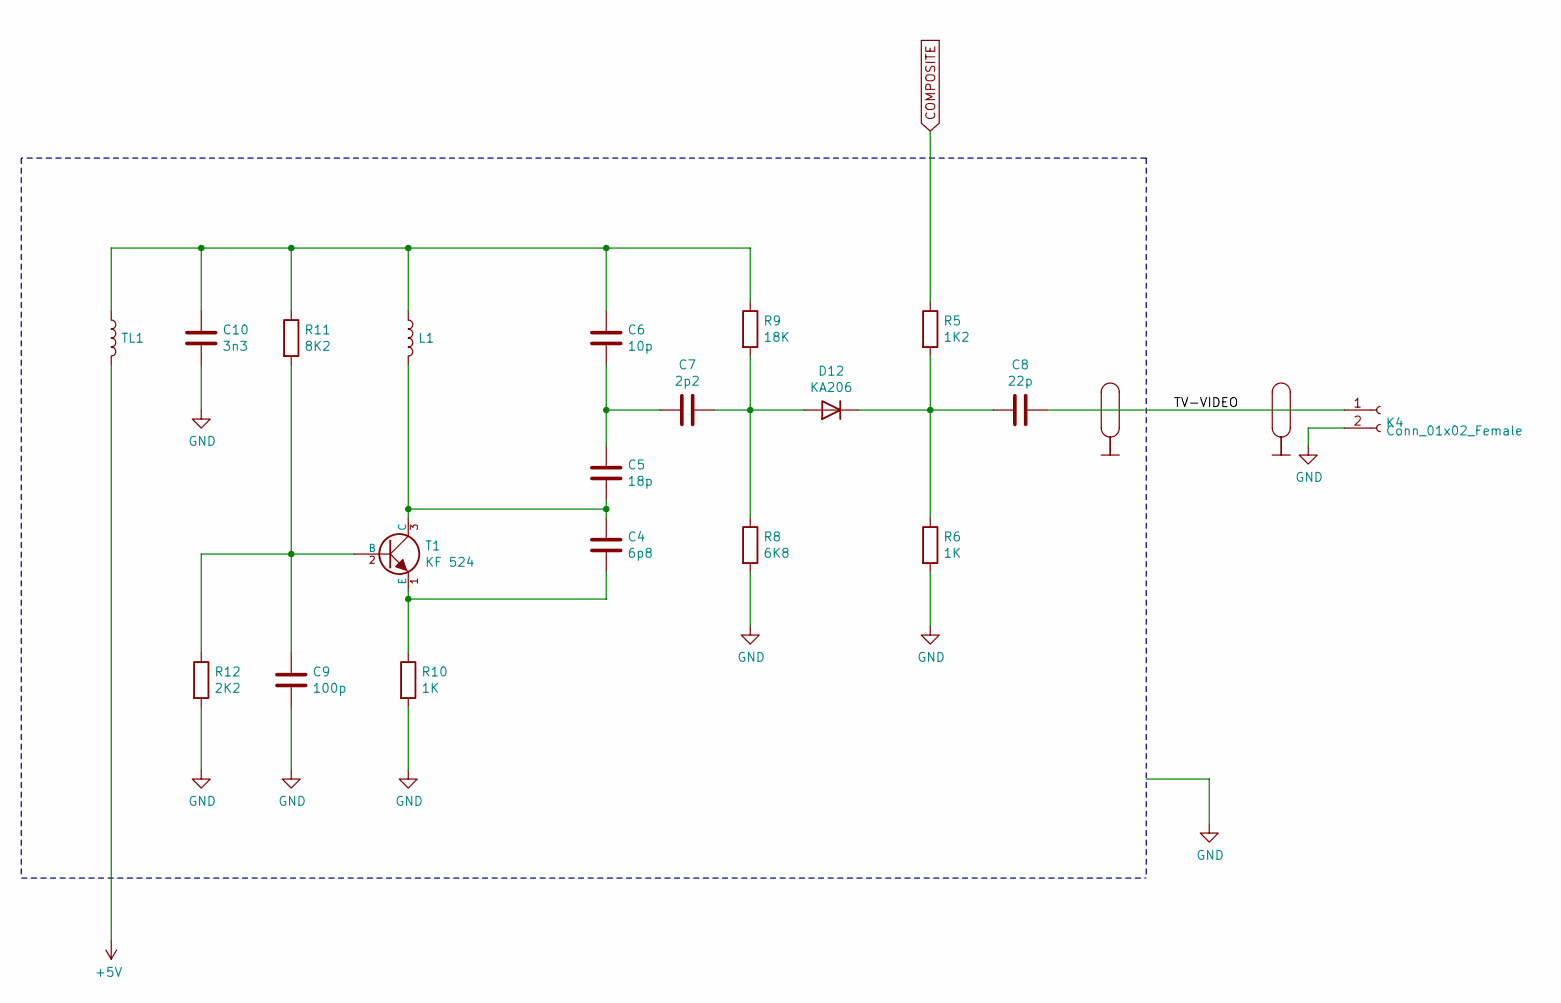
[picture p12: schematic modulator.sch]

Parts:
C4: 6p8; C_Disc_D3.0mm_W2.0mm_P2.50mm
C5: 18p; C_Disc_D3.0mm_W2.0mm_P2.50mm
C6: 10p; C_Disc_D3.0mm_W2.0mm_P2.50mm
C7: 2p2; C_Disc_D4.3mm_W1.9mm_P5.00mm
C8: 22p; C_Disc_D3.4mm_W2.1mm_P2.50mm
C9: 100p; C_Disc_D3.0mm_W2.0mm_P2.50mm
C10: 3n3; C_Disc_D3.0mm_W2.0mm_P2.50mm
D12: KA206; D_DO-34_SOD68_P7.62mm_Horizontal
K4: Conn_01x02_Female; mato-K6
L1: L; R_Axial_DIN0207_L6.3mm_D2.5mm_P15.24mm_Horizontal
R5: 1K2; R_Axial_DIN0204_L3.6mm_D1.6mm_P7.62mm_Horizontal
R6, R10: 1K; R_Axial_DIN0204_L3.6mm_D1.6mm_P7.62mm_Horizontal
R8: 6K8; R_Axial_DIN0204_L3.6mm_D1.6mm_P7.62mm_Horizontal
R9: 18K; R_Axial_DIN0204_L3.6mm_D1.6mm_P7.62mm_Horizontal
R11: 8K2; R_Axial_DIN0204_L3.6mm_D1.6mm_P7.62mm_Horizontal
R12: 2K2; R_Axial_DIN0204_L3.6mm_D1.6mm_P7.62mm_Horizontal
Sh2, Sh3: Shield
T1: KF 524; KF524
TL1: L; R_Axial_DIN0207_L6.3mm_D2.5mm_P10.16mm_Horizontal

Connections:
+5V: TL1.2; also elsewhere on the board
/modulator/TV-VIDEO: C8.2, K4.1
COMPOSITE: R5.1; also elsewhere on the board
GND: C9.2, C10.2, K4.2, R6.2, R8.2, R10.2, R12.2; also elsewhere on the board
unnamed: C4.1, C5.2, L1.2, T1.3 (C)
unnamed: C4.2, R10.1, T1.1 (E)
unnamed: C5.1, C6.2, C7.1
unnamed: C7.2, D12.2 (A), R8.1, R9.2
unnamed: C8.1, D12.1 (K), R5.2, R6.1
unnamed: C9.1, R11.2, R12.1, T1.2 (B)
unnamed: C6.1, C10.1, L1.1, R9.1, R11.1, TL1.1

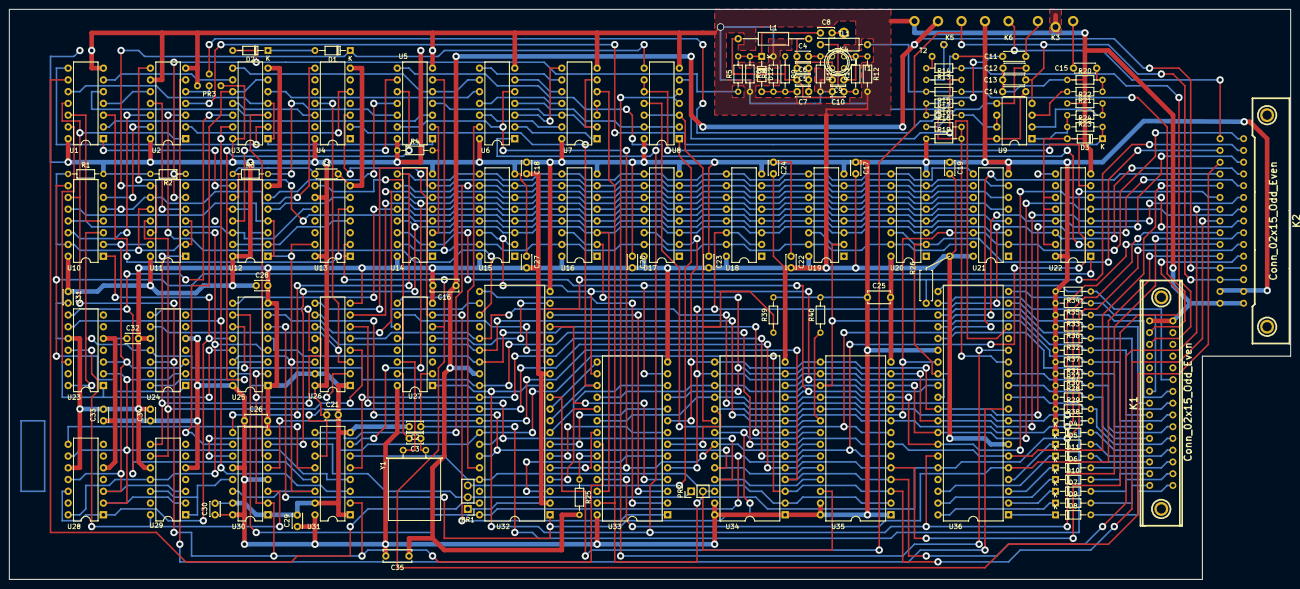
[picture p13: board Mato.kicad_pcb from above]

Board: 4 copper layers, 276.9 x 123.2 mm, 136 parts (0 on the bottom side), 184 nets.
